xujianningkp/Industrial-Control-Unit-ICU-Project/ICU FILES/HTML_PHP/images/background.png

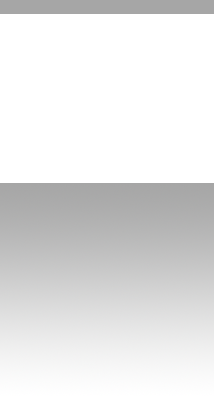
ICU FILES/HTML_PHP/images/background.png
