xujianningkp/Industrial-Control-Unit-ICU-Project/ICU FILES/HTML_PHP/images/home.PNG

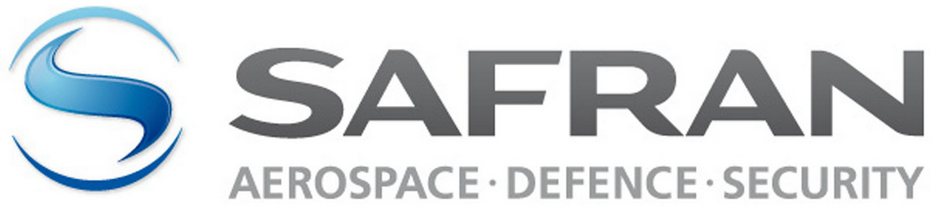
ICU FILES/HTML_PHP/images/home.PNG
